Surgical-Lighting-MIT-2-75-2024/SurgicalLightUserDisplay/UserDisplayModule-Rev2/UserDisplayModule.kicad_pcb

## KiCad design UserDisplayModule-Rev2/UserDisplayModule.kicad_pcb (2024-04-24)

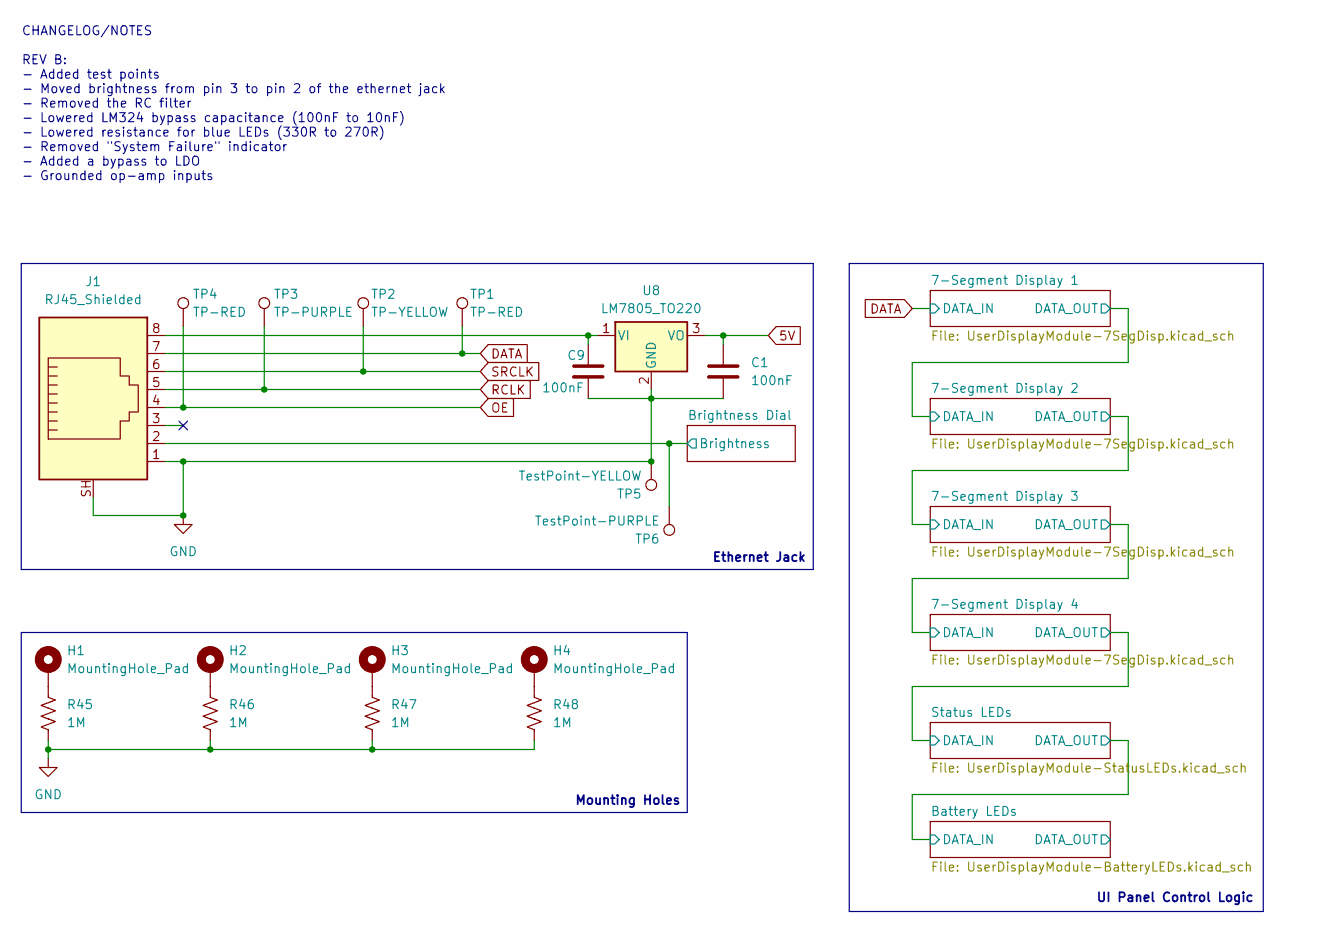
[picture p1: schematic UserDisplayModule.kicad_sch, Main]

Parts:
C1, C9: 100nF; C_0805_2012Metric
H1, H2, H3, H4: MountingHole_Pad; MountingHole_3.2mm_M3_Pad
J1: RJ45_Shielded; RJ45_Shielded_EthernetJack; Digikey PN AE10399-ND
R45, R46, R47, R48: 1M; R_0805_2012Metric; Digikey PN RMCF0805FT1M00CT-ND
TP1, TP4: TP-RED; TestPoint_Keystone_5000-5004_Miniature; Digikey PN 36-5260-ND
TP2: TP-YELLOW; TestPoint_Keystone_5000-5004_Miniature; Digikey PN 36-5264-ND
TP3: TP-PURPLE; TestPoint_Keystone_5000-5004_Miniature; Digikey PN 36-5269-ND
TP5: TestPoint-YELLOW; TestPoint_Keystone_5000-5004_Miniature; Digikey PN 36-5264-ND
TP6: TestPoint-PURPLE; TestPoint_Keystone_5000-5004_Miniature; Digikey PN 36-5269-ND
U8: LM7805_TO220; TO-220-3_Vertical; Digikey PN 2129-NJM7805FA-ND

Connections:
5V: C1.1, U8.3 (VO); also elsewhere on the board
/Brightness Dial/Brightness: J1.2, TP6.1; also elsewhere on the board
DATA: J1.7, TP1.1; also elsewhere on the board
GND: C1.2, C9.2, J1.1, J1.SH, R45.2, R46.2, R47.2, R48.2, TP5.1, U8.2 (GND); also elsewhere on the board
unnamed: H1.1, R45.1
unnamed: H2.1, R46.1
unnamed: H3.1, R47.1
unnamed: H4.1, R48.1
unnamed: C9.1, J1.8, U8.1 (VI)
OE: J1.4, TP4.1; also elsewhere on the board
RCLK: J1.5, TP3.1; also elsewhere on the board
SRCLK: J1.6, TP2.1; also elsewhere on the board

Notes on the sheet:
Mounting Holes
Ethernet Jack
UI Panel Control Logic
CHANGELOG/NOTES REV B: - Added test points - Moved brightness from pin 3 to pin 2 of the ethernet jack - Removed the RC filter - Lowered LM324 bypass capacitance (100nF to 10nF) - Lowered resistance for blue LEDs (330R to 270R) - Removed "System Failure" indicator - Added a bypass to LDO - Grounded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

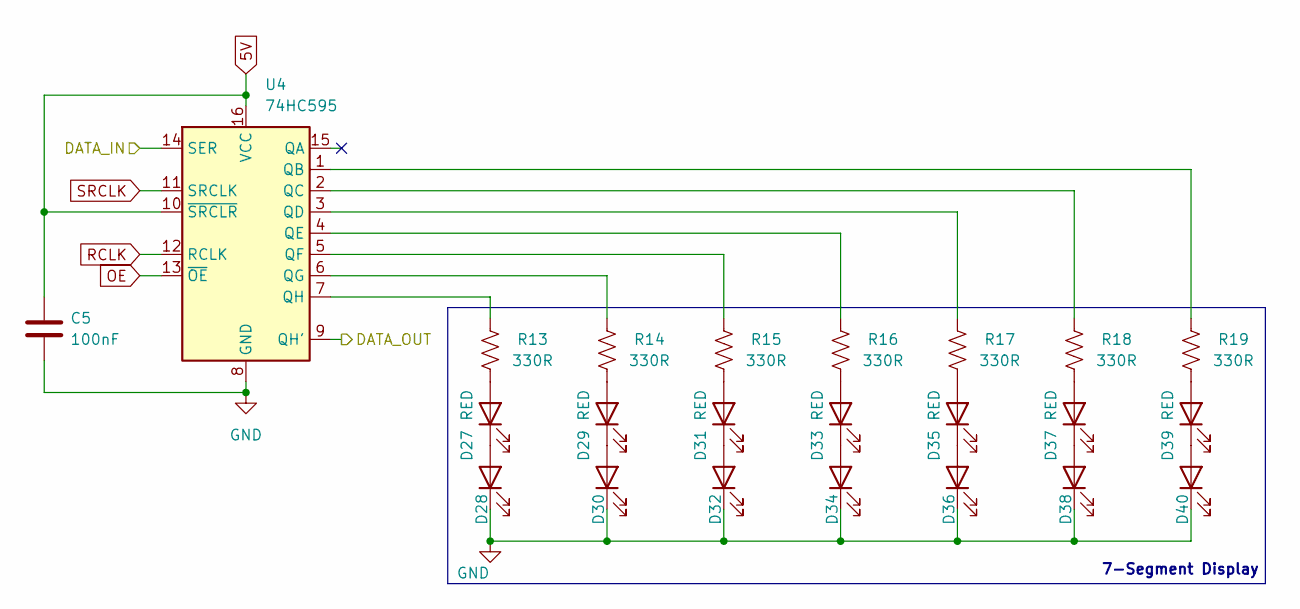
[picture p2: schematic UserDisplayModule-7SegDisp.kicad_sch]

Parts:
C5: 100nF; C_0805_2012Metric; Digikey PN 1276-1003-1-ND
D27, D28, D29, D30, D31, D32, D33, D34, D35, D36, D37, D38, D39, D40: RED; LED_0805_2012Metric; Digikey PN 732-4984-1-ND
R13, R14, R15, R16, R17, R18, R19: 330R; R_0805_2012Metric; Digikey PN RMCF0805FT330RCT-ND
U4: 74HC595; CD74HC595E; Digikey PN 296-1600-5-ND

Connections:
5V: C5.1, U4.10 (~SRCLR), U4.16 (VCC); also elsewhere on the board
/7-Segment Display 1/DATA_OUT: U4.9 (QH'); also elsewhere on the board
DATA: U4.14 (SER); also elsewhere on the board
GND: C5.2, D28.1 (K), D30.1 (K), D32.1 (K), D34.1 (K), D36.1 (K), D38.1 (K), D40.1 (K), U4.8 (GND); also elsewhere on the board
unnamed: D27.2 (A), R13.2
unnamed: D27.1 (K), D28.2 (A)
unnamed: D29.2 (A), R14.2
unnamed: D29.1 (K), D30.2 (A)
unnamed: D31.2 (A), R15.2
unnamed: D31.1 (K), D32.2 (A)
unnamed: D33.2 (A), R16.2
unnamed: D33.1 (K), D34.2 (A)
unnamed: D35.2 (A), R17.2
unnamed: D35.1 (K), D36.2 (A)
unnamed: D37.2 (A), R18.2
unnamed: D37.1 (K), D38.2 (A)
unnamed: D39.2 (A), R19.2
unnamed: D39.1 (K), D40.2 (A)
unnamed: R19.1, U4.1 (QB)
unnamed: R18.1, U4.2 (QC)
unnamed: R17.1, U4.3 (QD)
unnamed: R16.1, U4.4 (QE)
unnamed: R15.1, U4.5 (QF)
unnamed: R14.1, U4.6 (QG)
unnamed: R13.1, U4.7 (QH)
OE: U4.13 (~OE); also elsewhere on the board
RCLK: U4.12 (RCLK); also elsewhere on the board
SRCLK: U4.11 (SRCLK); also elsewhere on the board

Parts of its further copies:
C6, C7, C8: 100nF; C_0805_2012Metric; Digikey PN 1276-1003-1-ND
D46, D47, D48, D49, D50, D51, D52, D53, D54, D55, D56, D57, D58, D59, D60, D61, D62, D63, D64, D65, D66, D67, D68, D69, D70, D71, D72, D73, D74, D75, D76, D77, D78, D79, D80, D81, D82, D83, D84, D85, D86, D87: RED; LED_0805_2012Metric; Digikey PN 732-4984-1-ND
R24, R25, R26, R27, R28, R29, R30, R31, R32, R33, R34, R35, R36, R37, R38, R39, R40, R41, R42, R43, R44: 330R; R_0805_2012Metric; Digikey PN RMCF0805FT330RCT-ND
U3, U6, U7: 74HC595; CD74HC595E; Digikey PN 296-1600-5-ND

Connections of its further copies:
5V: C6.1, C7.1, C8.1, U3.10 (~SRCLR), U3.16 (VCC), U6.10 (~SRCLR), U6.16 (VCC), U7.10 (~SRCLR), U7.16 (VCC); also elsewhere on the board
/7-Segment Display 1/DATA_OUT: U3.14 (SER); also elsewhere on the board
/7-Segment Display 2/DATA_OUT: U3.9 (QH'), U6.14 (SER)
/7-Segment Display 3/DATA_OUT: U6.9 (QH'), U7.14 (SER)
/7-Segment Display 4/DATA_OUT: U7.9 (QH'); also elsewhere on the board
GND: C6.2, C7.2, C8.2, D47.1 (K), D49.1 (K), D51.1 (K), D53.1 (K), D55.1 (K), D57.1 (K), D59.1 (K), D61.1 (K), D63.1 (K), D65.1 (K), D67.1 (K), D69.1 (K), D71.1 (K), D73.1 (K), D75.1 (K), D77.1 (K), D79.1 (K), D81.1 (K), D83.1 (K), D85.1 (K), D87.1 (K), U3.8 (GND), U6.8 (GND), U7.8 (GND); also elsewhere on the board
unnamed: D46.2 (A), R24.2
unnamed: D46.1 (K), D47.2 (A)
unnamed: D48.2 (A), R25.2
unnamed: D48.1 (K), D49.2 (A)
unnamed: D50.2 (A), R26.2
unnamed: D50.1 (K), D51.2 (A)
unnamed: D52.2 (A), R27.2
unnamed: D52.1 (K), D53.2 (A)
unnamed: D54.2 (A), R28.2
unnamed: D54.1 (K), D55.2 (A)
unnamed: D56.2 (A), R29.2
unnamed: D56.1 (K), D57.2 (A)
unnamed: D58.2 (A), R30.2
unnamed: D58.1 (K), D59.2 (A)
unnamed: D60.2 (A), R31.2
unnamed: D60.1 (K), D61.2 (A)
unnamed: D62.2 (A), R32.2
unnamed: D62.1 (K), D63.2 (A)
unnamed: D64.2 (A), R33.2
unnamed: D64.1 (K), D65.2 (A)
unnamed: D66.2 (A), R34.2
unnamed: D66.1 (K), D67.2 (A)
unnamed: D68.2 (A), R35.2
unnamed: D68.1 (K), D69.2 (A)
unnamed: D70.2 (A), R36.2
unnamed: D70.1 (K), D71.2 (A)
unnamed: D72.2 (A), R37.2
unnamed: D72.1 (K), D73.2 (A)
unnamed: D74.2 (A), R38.2
unnamed: D74.1 (K), D75.2 (A)
unnamed: D76.2 (A), R39.2
unnamed: D76.1 (K), D77.2 (A)
unnamed: D78.2 (A), R40.2
unnamed: D78.1 (K), D79.2 (A)
unnamed: D80.2 (A), R41.2
unnamed: D80.1 (K), D81.2 (A)
unnamed: D82.2 (A), R42.2
unnamed: D82.1 (K), D83.2 (A)
unnamed: D84.2 (A), R43.2
unnamed: D84.1 (K), D85.2 (A)
unnamed: D86.2 (A), R44.2
unnamed: D86.1 (K), D87.2 (A)
unnamed: R30.1, U3.1 (QB)
unnamed: R29.1, U3.2 (QC)
unnamed: R28.1, U3.3 (QD)
unnamed: R27.1, U3.4 (QE)
unnamed: R26.1, U3.5 (QF)
unnamed: R25.1, U3.6 (QG)
unnamed: R24.1, U3.7 (QH)
unnamed: R37.1, U6.1 (QB)
unnamed: R36.1, U6.2 (QC)
unnamed: R35.1, U6.3 (QD)
unnamed: R34.1, U6.4 (QE)
unnamed: R33.1, U6.5 (QF)
unnamed: R32.1, U6.6 (QG)
unnamed: R31.1, U6.7 (QH)
unnamed: R44.1, U7.1 (QB)
unnamed: R43.1, U7.2 (QC)
unnamed: R42.1, U7.3 (QD)
unnamed: R41.1, U7.4 (QE)
unnamed: R40.1, U7.5 (QF)
unnamed: R39.1, U7.6 (QG)
unnamed: R38.1, U7.7 (QH)
OE: U3.13 (~OE), U6.13 (~OE), U7.13 (~OE); also elsewhere on the board
RCLK: U3.12 (RCLK), U6.12 (RCLK), U7.12 (RCLK); also elsewhere on the board
SRCLK: U3.11 (SRCLK), U6.11 (SRCLK), U7.11 (SRCLK); also elsewhere on the board

Notes on the sheet:
7-Segment Display

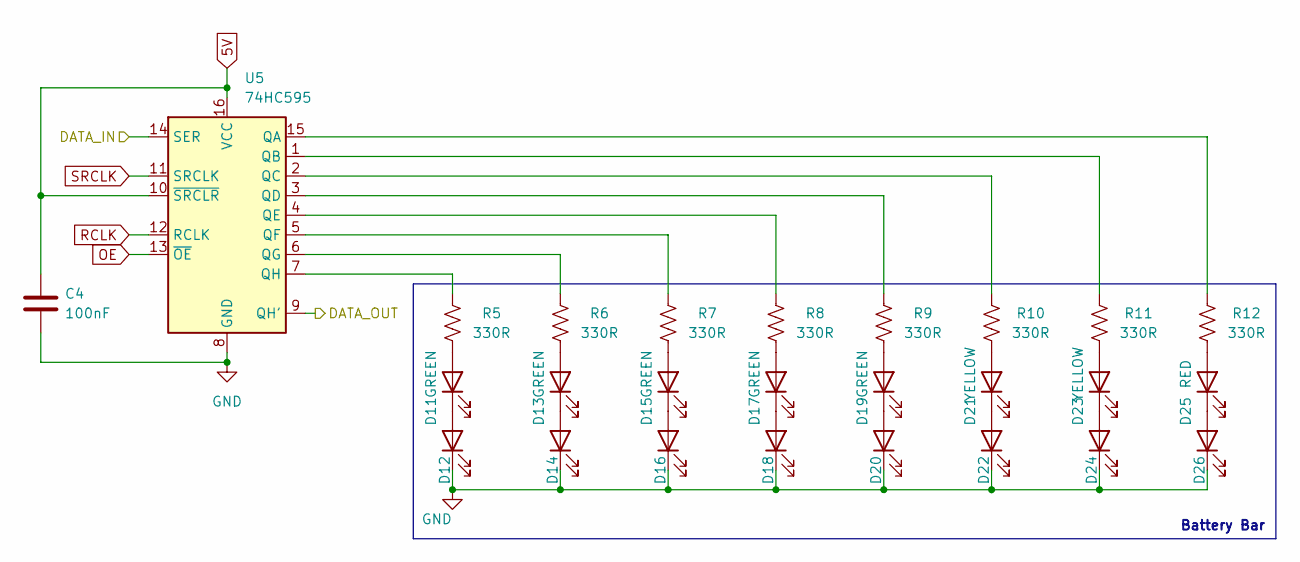
[picture p3: schematic UserDisplayModule-BatteryLEDs.kicad_sch]

Parts:
C4: 100nF; C_0805_2012Metric; Digikey PN 1276-1003-1-ND
D11, D12, D13, D14, D15, D16, D17, D18, D19, D20: GREEN; LED_0805_2012Metric; Digikey PN 732-4983-1-ND
D21, D22, D23, D24: YELLOW; LED_0805_2012Metric; Digikey PN 732-4987-1-ND
D25, D26: RED; LED_0805_2012Metric; Digikey PN 732-4984-1-ND
R5, R6, R7, R8, R9, R10, R11, R12: 330R; R_0805_2012Metric; Digikey PN RMCF0805FT330RCT-ND
U5: 74HC595; CD74HC595E; Digikey PN 296-1600-5-ND

Connections:
5V: C4.1, U5.10 (~SRCLR), U5.16 (VCC); also elsewhere on the board
/Battery LEDs/DATA_IN: U5.14 (SER); also elsewhere on the board
/Battery LEDs/DATA_OUT: U5.9 (QH')
GND: C4.2, D12.1 (K), D14.1 (K), D16.1 (K), D18.1 (K), D20.1 (K), D22.1 (K), D24.1 (K), D26.1 (K), U5.8 (GND); also elsewhere on the board
unnamed: D11.2 (A), R5.2
unnamed: D11.1 (K), D12.2 (A)
unnamed: D13.2 (A), R6.2
unnamed: D13.1 (K), D14.2 (A)
unnamed: D15.2 (A), R7.2
unnamed: D15.1 (K), D16.2 (A)
unnamed: D17.2 (A), R8.2
unnamed: D17.1 (K), D18.2 (A)
unnamed: D19.2 (A), R9.2
unnamed: D19.1 (K), D20.2 (A)
unnamed: D21.2 (A), R10.2
unnamed: D21.1 (K), D22.2 (A)
unnamed: D23.2 (A), R11.2
unnamed: D23.1 (K), D24.2 (A)
unnamed: D25.2 (A), R12.2
unnamed: D25.1 (K), D26.2 (A)
unnamed: R12.1, U5.15 (QA)
unnamed: R11.1, U5.1 (QB)
unnamed: R10.1, U5.2 (QC)
unnamed: R9.1, U5.3 (QD)
unnamed: R8.1, U5.4 (QE)
unnamed: R7.1, U5.5 (QF)
unnamed: R6.1, U5.6 (QG)
unnamed: R5.1, U5.7 (QH)
OE: U5.13 (~OE); also elsewhere on the board
RCLK: U5.12 (RCLK); also elsewhere on the board
SRCLK: U5.11 (SRCLK); also elsewhere on the board

Notes on the sheet:
Battery Bar

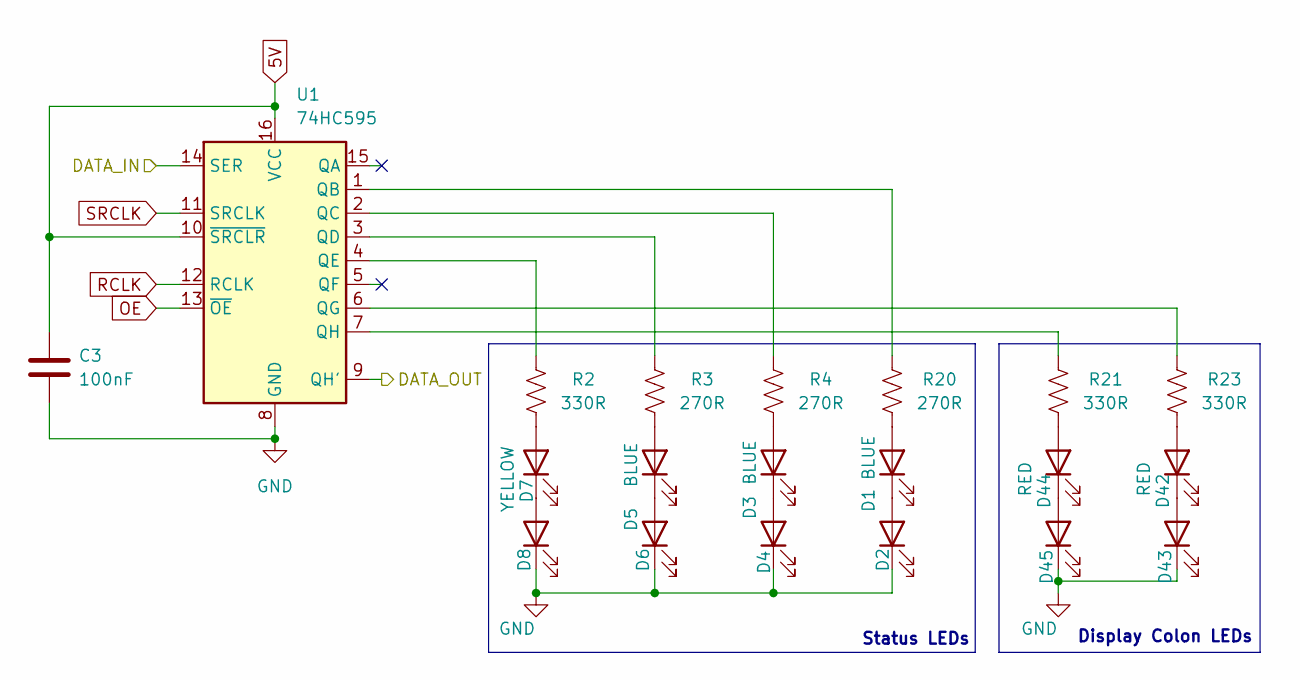
[picture p4: schematic UserDisplayModule-StatusLEDs.kicad_sch]

Parts:
C3: 100nF; C_0805_2012Metric; Digikey PN 1276-1003-1-ND
D1, D2, D3, D4, D5, D6: BLUE; LED_0805_2012Metric; Digikey PN 732-4982-1-ND
D7, D8: YELLOW; LED_0805_2012Metric; Digikey PN 732-4987-1-ND
D42, D43, D44, D45: RED; LED_0805_2012Metric; Digikey PN 732-4984-1-ND
R2, R21, R23: 330R; R_0805_2012Metric; Digikey PN RMCF0805FT330RCT-ND
R3, R4, R20: 270R; R_0805_2012Metric; Digikey PN RMCF0805FT330RCT-ND
U1: 74HC595; CD74HC595E; Digikey PN 296-1600-5-ND

Connections:
5V: C3.1, U1.10 (~SRCLR), U1.16 (VCC); also elsewhere on the board
/7-Segment Display 4/DATA_OUT: U1.14 (SER); also elsewhere on the board
/Battery LEDs/DATA_IN: U1.9 (QH'); also elsewhere on the board
GND: C3.2, D2.1 (K), D4.1 (K), D6.1 (K), D8.1 (K), D43.1 (K), D45.1 (K), U1.8 (GND); also elsewhere on the board
unnamed: D1.2 (A), R20.2
unnamed: D1.1 (K), D2.2 (A)
unnamed: D3.2 (A), R4.2
unnamed: D3.1 (K), D4.2 (A)
unnamed: D5.2 (A), R3.2
unnamed: D5.1 (K), D6.2 (A)
unnamed: D7.2 (A), R2.2
unnamed: D7.1 (K), D8.2 (A)
unnamed: D42.2 (A), R23.2
unnamed: D42.1 (K), D43.2 (A)
unnamed: D44.2 (A), R21.2
unnamed: D44.1 (K), D45.2 (A)
unnamed: R20.1, U1.1 (QB)
unnamed: R4.1, U1.2 (QC)
unnamed: R3.1, U1.3 (QD)
unnamed: R2.1, U1.4 (QE)
unnamed: R23.1, U1.6 (QG)
unnamed: R21.1, U1.7 (QH)
OE: U1.13 (~OE); also elsewhere on the board
RCLK: U1.12 (RCLK); also elsewhere on the board
SRCLK: U1.11 (SRCLK); also elsewhere on the board

Notes on the sheet:
Status LEDs
Display Colon LEDs

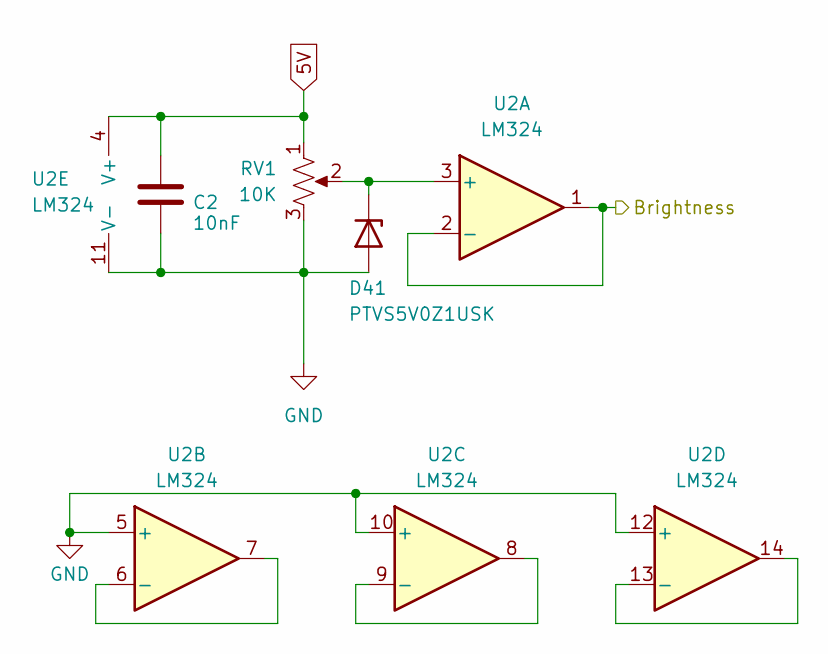
[picture p5: schematic UserDisplayModule-BrightnessDial.kicad_sch]

Parts:
C2: 10nF; C_0805_2012Metric; Digikey PN 1276-1003-1-ND
D41: PTVS5V0Z1USK; Nexperia_DSN1608-2_1.6x0.8mm; Digikey PN 1727-2742-1-ND
RV1: 10K; Potentiometer_TT_P0915N; Digikey PN 987-1649-ND
U2: LM324; DIP-14_W7.62mm; Digikey PN 296-1391-5-ND

Connections:
5V: C2.1, RV1.1, U2.4 (V+); also elsewhere on the board
/Brightness Dial/Brightness: U2.1, U2.2 (-); also elsewhere on the board
GND: C2.2, D41.2 (A), RV1.3, U2.5 (+), U2.10 (+), U2.11 (V-), U2.12 (+); also elsewhere on the board
unnamed: D41.1 (K), RV1.2, U2.3 (+)
unnamed: U2.6 (-), U2.7
unnamed: U2.8, U2.9 (-)
unnamed: U2.13 (-), U2.14

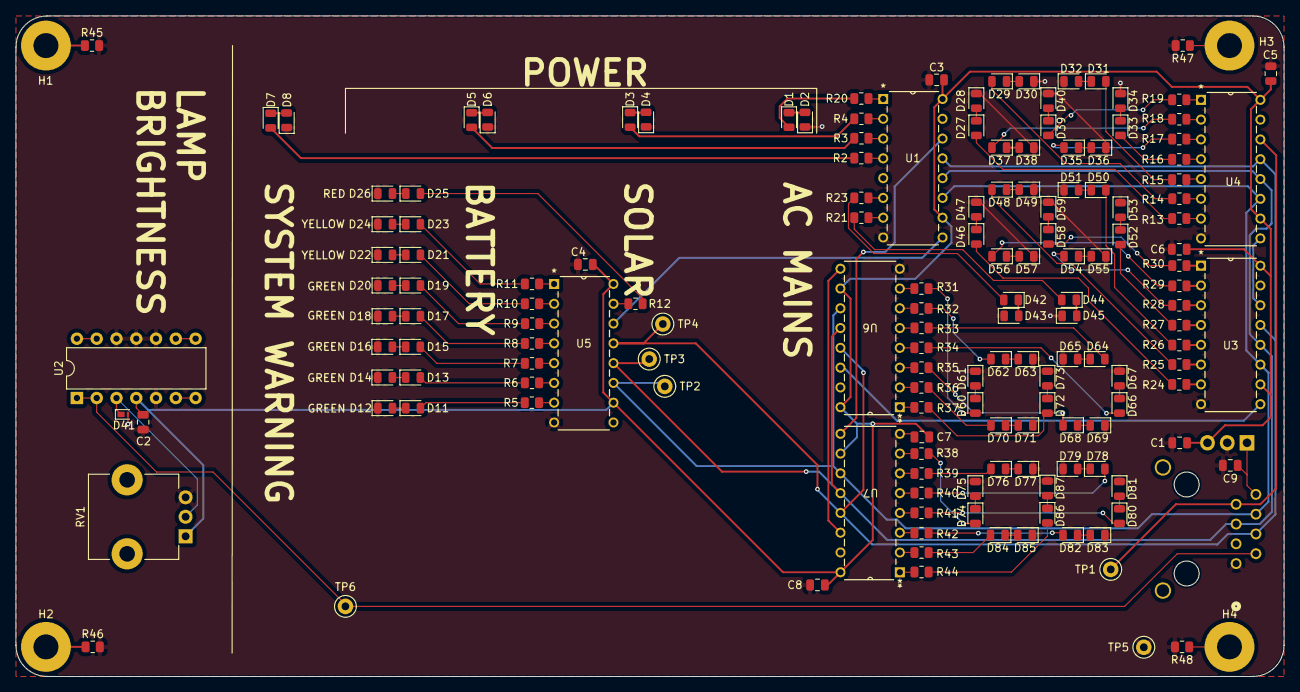
[picture p6: board UserDisplayModule.kicad_pcb from above]

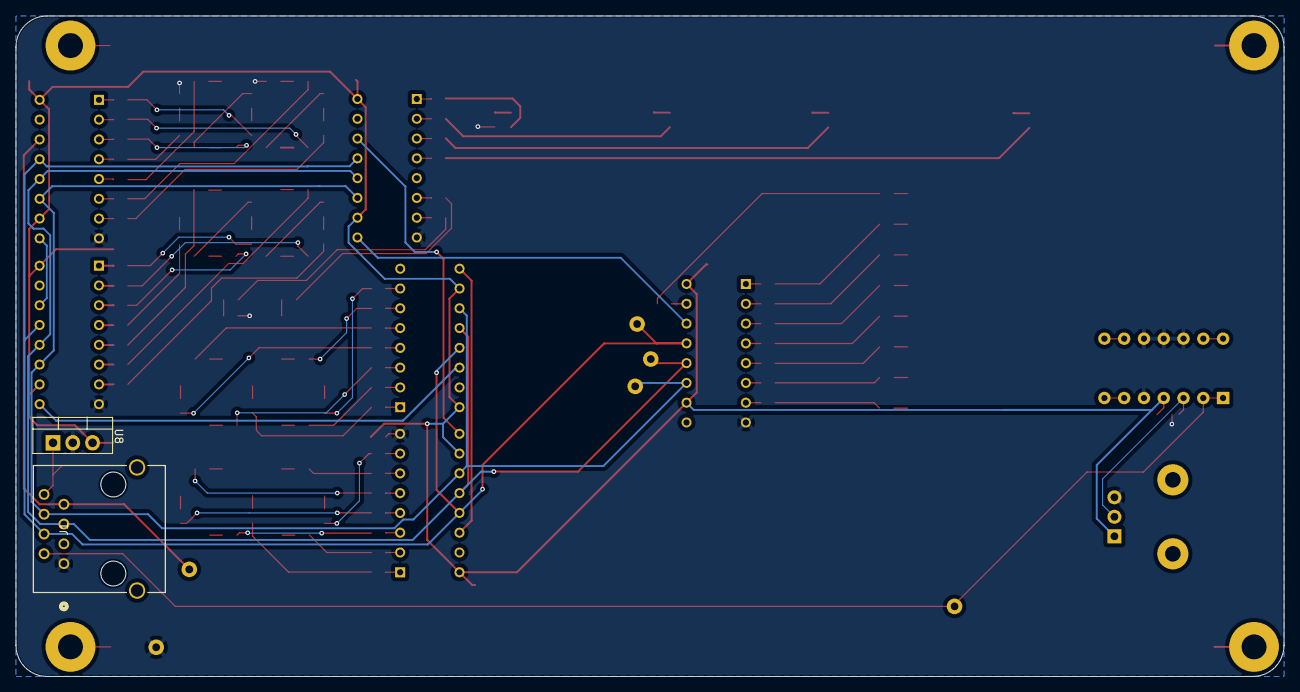
[picture p7: board UserDisplayModule.kicad_pcb from below]

Board: 2 copper layers, 162.8 x 84.8 mm, 160 parts (2 on the bottom side), 147 nets.
