Surgical-Lighting-MIT-2-75-2024/SurgicalLightUserDisplay/(commit log)

2024-03-23 started user display module schematic
    [7-seg-led.kicad_sch, UserDisplayModule.kicad_pcb, UserDisplayModule.kicad_sch]
2024-03-26 finished schematic + addressed comments
    [UserDisplayModule-7SegDisp.kicad_sch, UserDisplayModule-BatteryLEDs.kicad_sch, UserDisplayModule-BrightnessDial.kicad_sch, UserDisplayModule-StatusLEDs.kicad_sch, UserDisplayModule.kicad_sch]
2024-03-28 doubled LEDs + started PCB
    [UserDisplayModule-7SegDisp.kicad_sch, UserDisplayModule-BatteryLEDs.kicad_sch, UserDisplayModule-BrightnessDial.kicad_sch, UserDisplayModule-StatusLEDs.kicad_sch, UserDisplayModule.kicad_pcb, UserDisplayModule.kicad_sch]
2024-03-28 started routing (help)
    [UserDisplayModule-StatusLEDs.kicad_sch, UserDisplayModule.kicad_pcb]
2024-03-29 finished routing pcb (minus ground pour)
    [UserDisplayModule-7SegDisp.kicad_sch, UserDisplayModule-BatteryLEDs.kicad_sch, UserDisplayModule-BrightnessDial.kicad_sch, UserDisplayModule-StatusLEDs.kicad_sch, UserDisplayModule.kicad_pcb, UserDisplayModule.kicad_sch]
2024-03-29 added ground pour + finished routing
    [UserDisplayModule.kicad_pcb]
2024-04-01 added 3d models, fixed footprints, finished routing
    [UserDisplayModule-7SegDisp.kicad_sch, UserDisplayModule-BatteryLEDs.kicad_sch, UserDisplayModule-BrightnessDial.kicad_sch, UserDisplayModule-StatusLEDs.kicad_sch, UserDisplayModule.kicad_pcb, UserDisplayModule.kicad_sch]
2024-04-03 added digikey pns
    [UserDisplayModule-7SegDisp.kicad_sch, UserDisplayModule-BatteryLEDs.kicad_sch, UserDisplayModule-BrightnessDial.kicad_sch, UserDisplayModule-StatusLEDs.kicad_sch, UserDisplayModule.kicad_pcb, UserDisplayModule.kicad_sch]
2024-04-03 Edited BOM for R/C parts
    [UserDisplayModule-7SegDisp.kicad_sch, UserDisplayModule-BatteryLEDs.kicad_sch, UserDisplayModule-BrightnessDial.kicad_sch, UserDisplayModule-StatusLEDs.kicad_sch, UserDisplayModule.kicad_sch]
2024-04-03 added digikey PNs to diode and pot
    [UserDisplayModule-BrightnessDial.kicad_sch]
2024-04-24 added rev 2
    [7-seg-led.kicad_sch, UserDisplayModule-7SegDisp.kicad_sch, UserDisplayModule-BatteryLEDs.kicad_sch, UserDisplayModule-BrightnessDial.kicad_sch, UserDisplayModule-StatusLEDs.kicad_sch, UserDisplayModule.kicad_pcb, UserDisplayModule.kicad_sch]
2024-04-24 more changes: ldo bypass + grounding op amp
    [UserDisplayModule-BrightnessDial.kicad_sch, UserDisplayModule.kicad_pcb, UserDisplayModule.kicad_sch]
